slallem/vectorland/documentation/cartridge_port.png

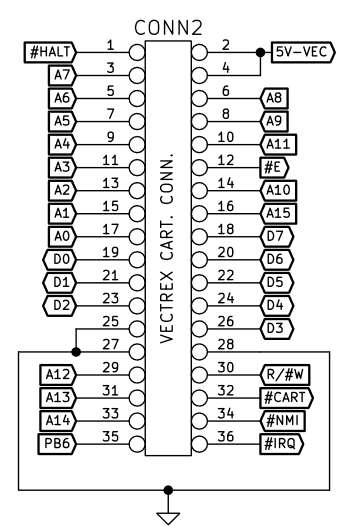
documentation/cartridge_port.png
