slallem/vectorland/cartridge/shell/cart-shell-v1.00/cart-for-PCB-v1.00.stl

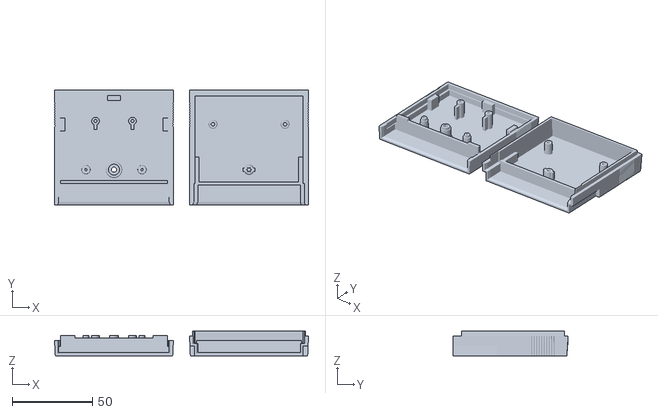
[picture p2: CAD file, 2024-04-19]
cartridge/shell/cart-shell-v1.00/cart-for-PCB-v1.00.stl
158.6 x 72.0 x 15.5
