slallem/vectorland/(list of files, cad)

Other CAD files:
cartridge/shell/cart-shell-v1.00/cart-v1-all-in-one.stl
cartridge/shell/cart-shell-v1.00/cart-v1-all-in-one.scad
