slallem/vectorland/cartridge/pcb/vx_cart_v1.01/vectrex_cart_v1.01.kicad_pcb

## KiCad design cartridge/pcb/vx_cart_v1.01/vectrex_cart_v1.01.kicad_pcb (2024-04-23)

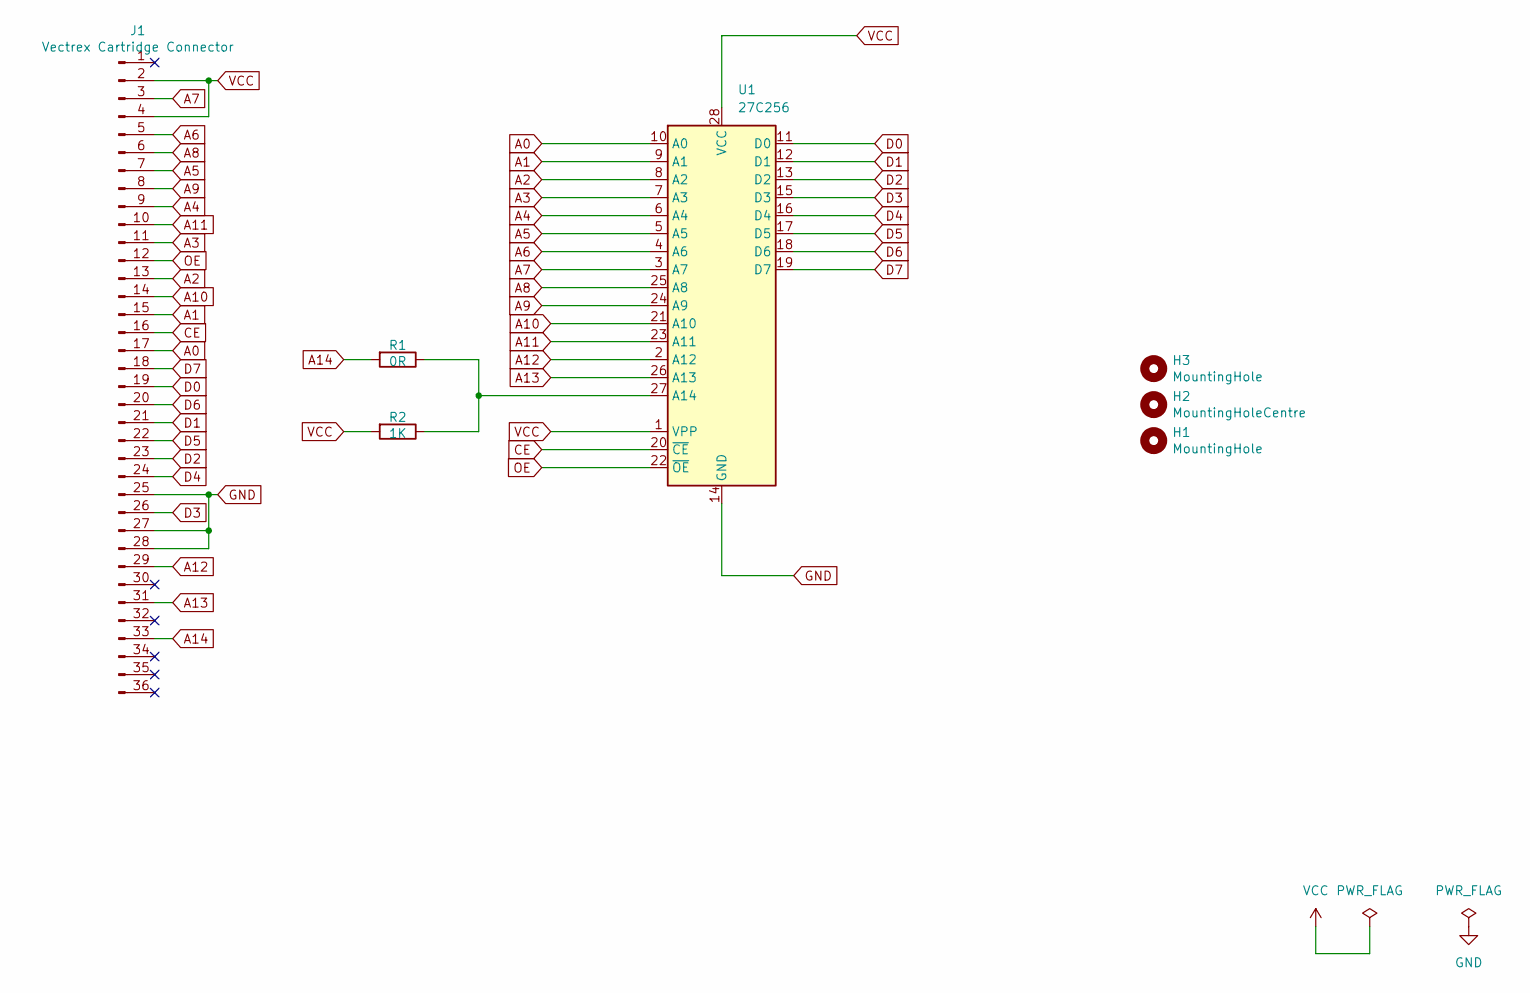
[picture p3: schematic vectrex_cart_v1.01.kicad_sch, Vectrex cartridge PCB]

Parts:
H1, H3: MountingHole; MountingHole_3.7mm
H2: MountingHoleCentre; MountingHole_5.3mm_M5
J1: Vectrex Cartridge Connector; VECTREX_CART
R1: 0R; R_Axial_DIN0204_L3.6mm_D1.6mm_P7.62mm_Horizontal
R2: 1K; R_Axial_DIN0204_L3.6mm_D1.6mm_P7.62mm_Horizontal
U1: 27C256; DIP-28_W15.24mm_LongPads

Connections:
A0: J1.17, U1.10 (A0)
A1: J1.15, U1.9 (A1)
A2: J1.13, U1.8 (A2)
A3: J1.11, U1.7 (A3)
A4: J1.9, U1.6 (A4)
A5: J1.7, U1.5 (A5)
A6: J1.5, U1.4 (A6)
A7: J1.3, U1.3 (A7)
A8: J1.6, U1.25 (A8)
A9: J1.8, U1.24 (A9)
A10: J1.14, U1.21 (A10)
A11: J1.10, U1.23 (A11)
A12: J1.29, U1.2 (A12)
A13: J1.31, U1.26 (A13)
A14: J1.33, R1.2
CE: J1.16, U1.20 (~CE)
D0: J1.19, U1.11 (D0)
D1: J1.21, U1.12 (D1)
D2: J1.23, U1.13 (D2)
D3: J1.26, U1.15 (D3)
D4: J1.24, U1.16 (D4)
D5: J1.22, U1.17 (D5)
D6: J1.20, U1.18 (D6)
D7: J1.18, U1.19 (D7)
GND: J1.25, J1.27, J1.28, U1.14 (GND)
unnamed: R1.1, R2.1, U1.27 (A14)
OE: J1.12, U1.22 (~OE)
VCC: J1.2, J1.4, R2.2, U1.1 (VPP), U1.28 (VCC)

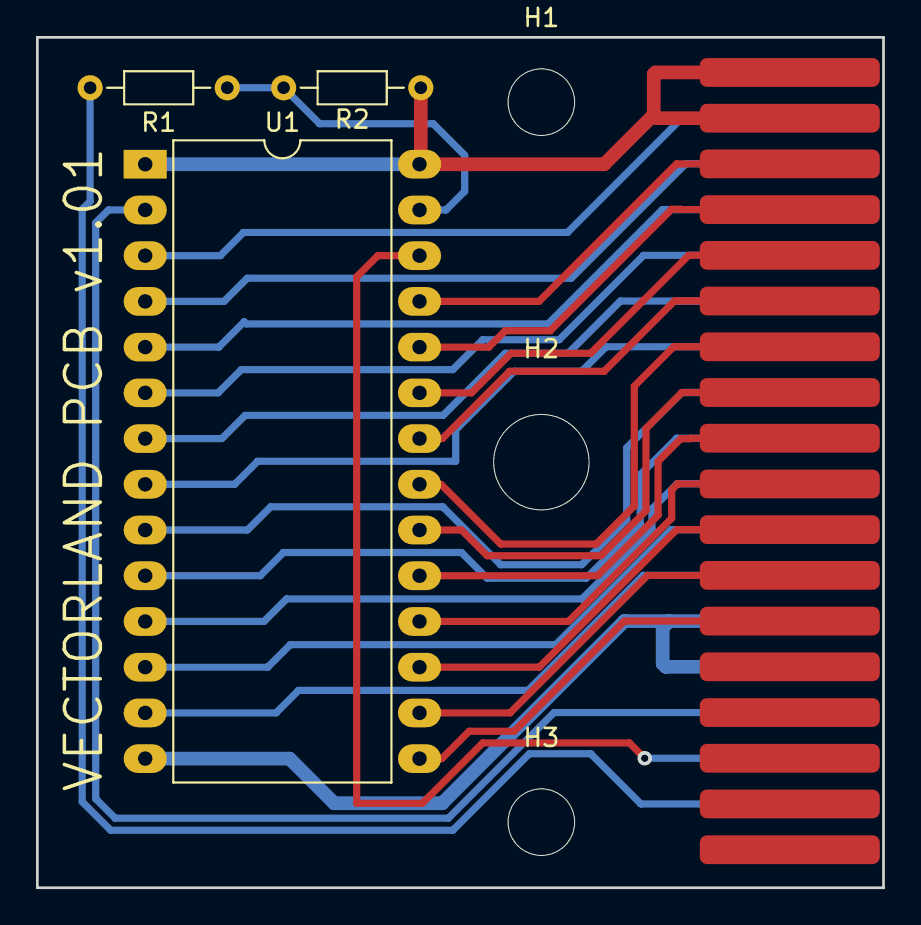
[picture p4: board vectrex_cart_v1.01.kicad_pcb from above]

Board: 2 copper layers, 47.0 x 47.2 mm, 7 parts (0 on the bottom side), 28 nets.
