slallem/vectorland/(commit log)

2024-04-03 Initial version
    [cart-v1-all-in-one.scad, cart-v1-all-in-one.stl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]
2024-04-18 Introducing PCB v1.01
    [cart-for-PCB-v1.00.scad, cart-v1-all-in-one.scad, cart-v1-all-in-one.stl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]
2024-04-18 Carte shell adjustment for PCB v1.00
    [cart-for-PCB-v1.00.scad, cart-for-PCB-v1.00.stl]
2024-04-23 Cart PCB v1.01
    [vectrex_cart_v1.01-B_Cu.gbl, vectrex_cart_v1.01-B_Mask.gbs, vectrex_cart_v1.01-B_Silkscreen.gbo, vectrex_cart_v1.01-Edge_Cuts.gm1, vectrex_cart_v1.01-F_Cu.gtl, vectrex_cart_v1.01-F_Mask.gts, vectrex_cart_v1.01-F_Silkscreen.gto, vectrex_cart_v1.01-NPTH.drl]
